upenn-embedded/final-project-website-submission-f25-t01-f25-ctrl-alt-del/image/README/1761426687986.png

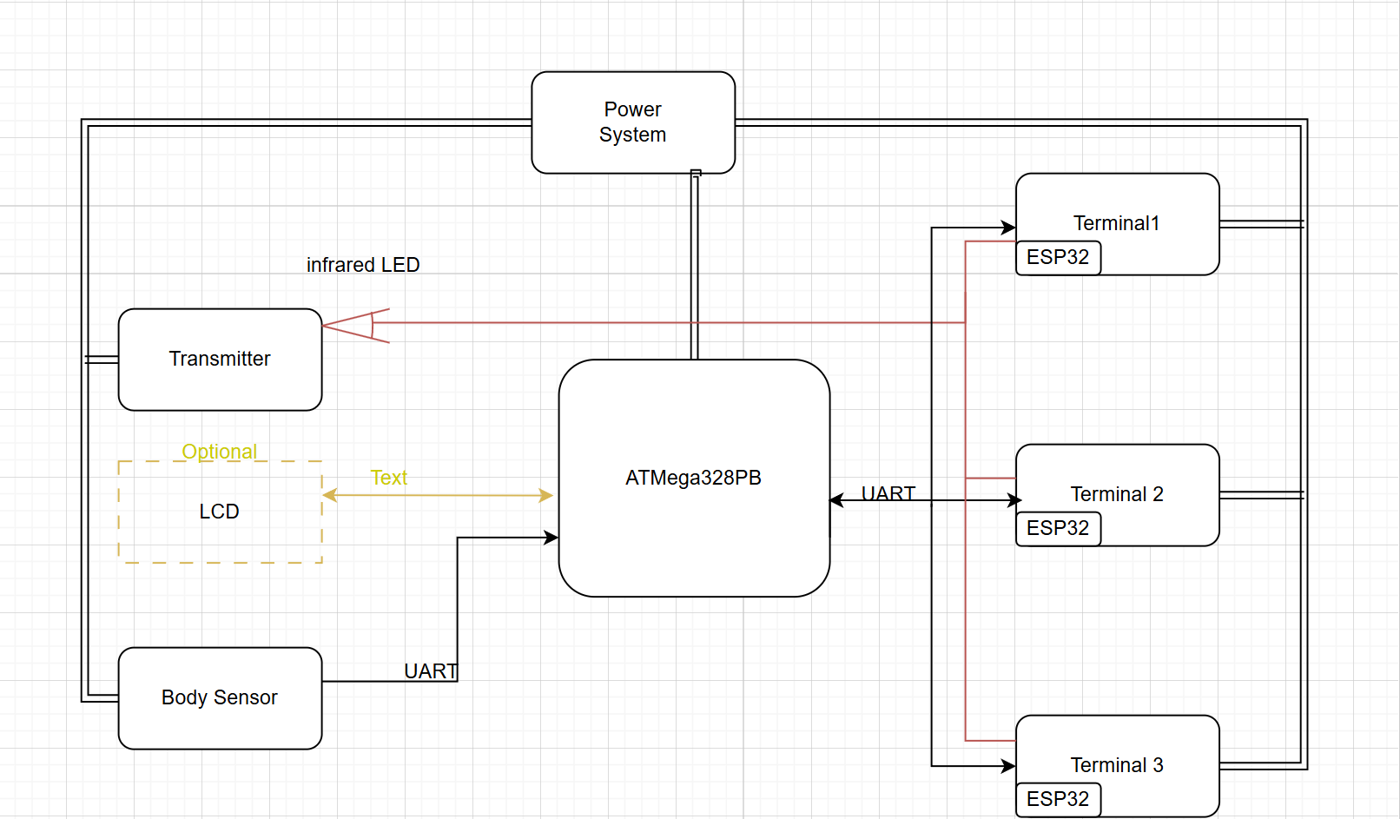
image/README/1761426687986.png
