upenn-embedded/final-project-website-submission-f25-t01-f25-ctrl-alt-del/image/README/1763172037796.png

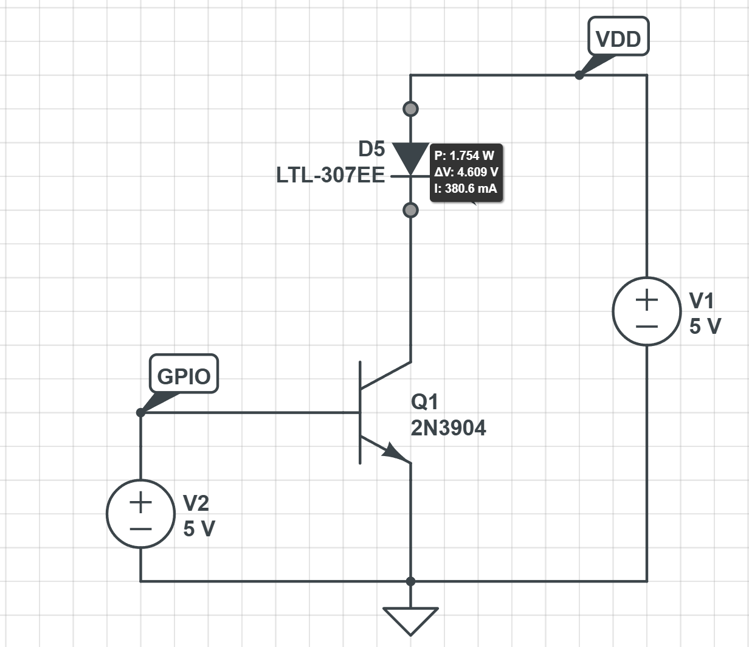
image/README/1763172037796.png
