upenn-embedded/final-project-website-submission-f25-t01-f25-ctrl-alt-del/(commit log)

2025-10-25 TEAMCONTRACT: update
    [meeting_timeline.xlsx]
2025-10-25 README：update
2025-11-06 UPADATE：SRS
2025-11-06 UPDATE: HRS, DEMO, BOM
2025-11-06 UPDATE：format
2025-11-26 已添加 MVP demo.png
2025-11-27 CODE:ESP32 update
2025-12-09 README：edit
